eCafe-Racer/kicad-parts-library/models/ESP32-WROOM-32D.step

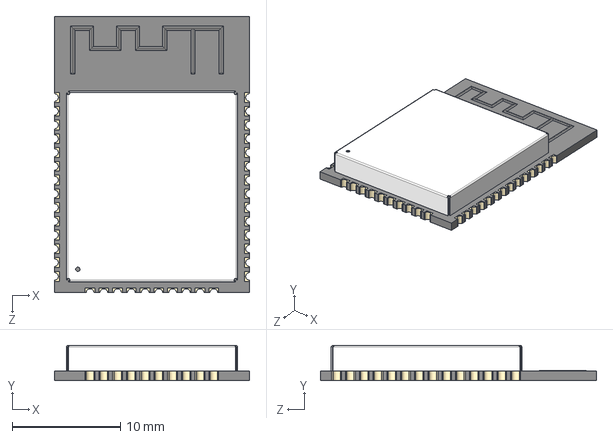
[picture p1: CAD file, 2021-08-06]
models/ESP32-WROOM-32D.step
18.0 x 3.25 x 25.5 mm
