eCafe-Racer/kicad-parts-library/models/CUI-TBL004-508-08BE-2GY.step

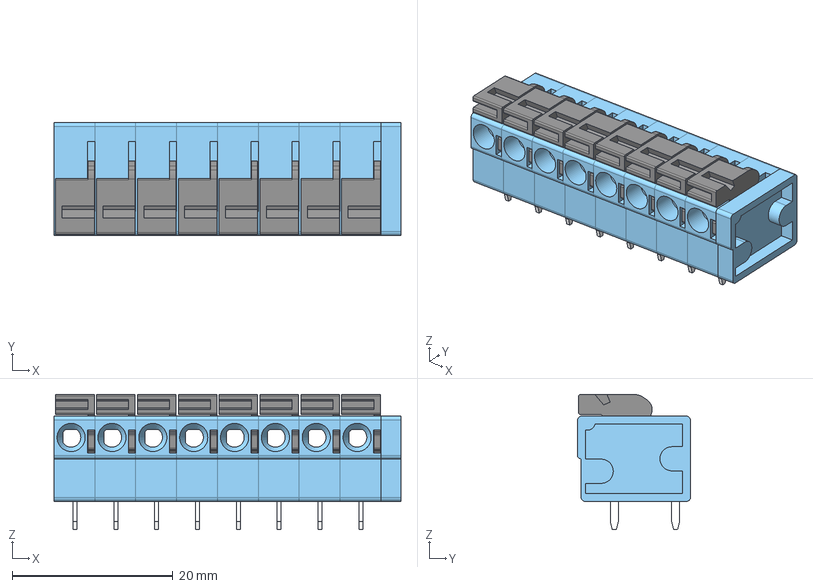
[picture p2: CAD file, 2021-01-22]
models/CUI-TBL004-508-08BE-2GY.step
43.1 x 14.1 x 16.8 mm
TBL004-508 - PUSH BUTTON_Black x 8
TBL004-508 - BODY_Blue x 8
TBL004-508 - END CAP_Blue
