eCafe-Racer/kicad-parts-library/models/Molex-936358314(RJ45).step

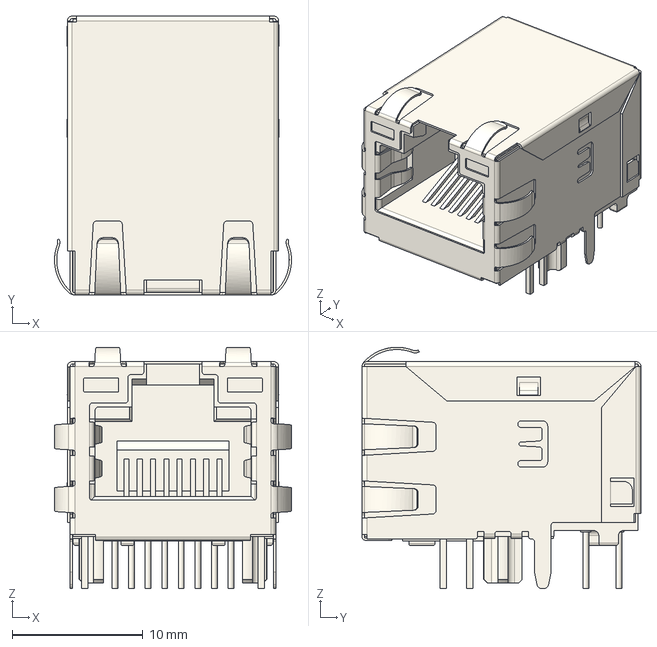
[picture p3: CAD file, 2021-01-21]
models/Molex-936358314(RJ45).step
18.2 x 21.4 x 18.5 mm
