eCafe-Racer/kicad-parts-library/models/Molex-2086588131.step

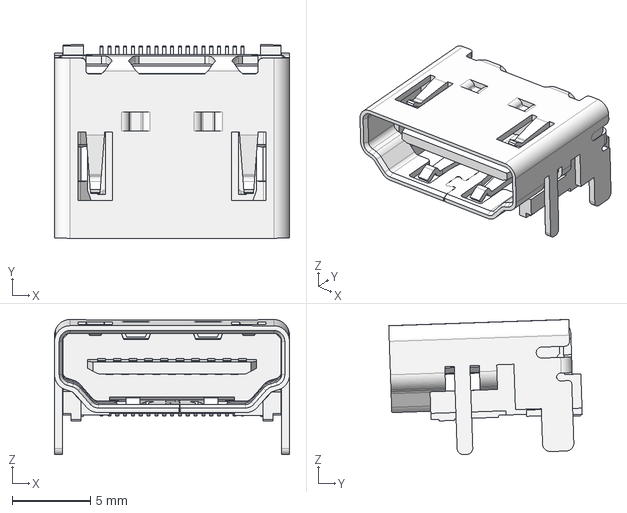
[picture p4: CAD file, 2021-01-21]
models/Molex-2086588131.step
15.0 x 12.4 x 8.63 mm
