eCafe-Racer/kicad-parts-library/models/1981568-1.stp

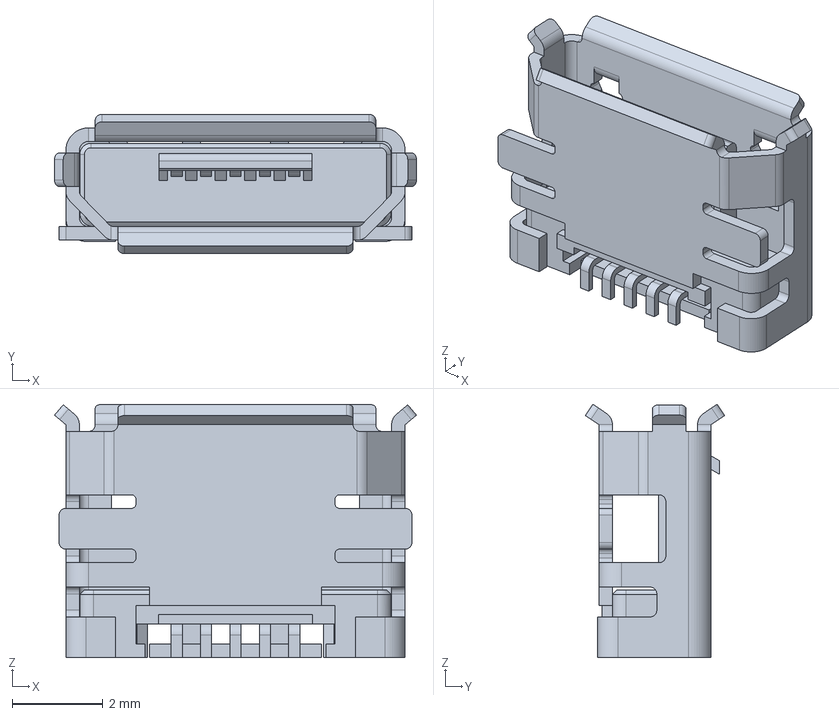
[picture p5: CAD file, 2021-08-06]
models/1981568-1.stp
8.00 x 3.08 x 5.60 mm
