eCafe-Racer/kicad-parts-library/(commit log)

2020-11-28 high power PMOS transistor
2020-11-28 switched to new file format
2020-11-28 started footprint library, added compute module
2020-12-29 Added custom inductor for power supply
2020-12-29 Added I2C IO expander
2021-01-19 Molex RJ45 Connector
2021-01-20 Stacked USB type A connector
2021-01-21 HDMI connector
    [Molex-2086588131.step]
2021-01-21 HDMI connector symbol
2021-01-21 RJ45 connector footprint
    [Molex-936358314(RJ45).step]
2021-01-22 Push connector
    [CUI-TBL004-508-08BE-2GY.step]
2021-02-04 12V Barrel Jack
2021-02-04 misc. footprint assignments
2021-02-18 updated pin numbers on resistor array
2021-03-02 couple new components
2021-06-21 mcp2221A - usb to uart/i2c/gpio chip
2021-06-21 micro usb connector
2021-06-27 specified output voltage on LM1084IS regulator
2021-06-27 added 3.3V version on LM1084IS
2021-08-06 added some 3d models
    [1981568-1.stp, ESP32-WROOM-32D.step]
